winter459316/shenmu/report/support/README.md

# 报告支撑文件

- `migration_evidence_manifest.json`：工程及结果文件索引。
- `evidence_manifest.json`：设计依据文件索引。
- `requirements_host_observed.txt`：依赖信息。

安装依赖以 `board/config/requirements_runtime.txt` 为准。运行文件映射见 `board/config/source_map.json`，包内文件完整性清单见 `data/provenance/manifest.json`。
