winter459316/shenmu/report/architecture.md

# 系统架构与计算分工

```mermaid
flowchart LR
    model[腹腔肿块模型] --> camera[USB 双目摄像头]
    camera --> ps[A53：采集、调度及网络运算]
    ps <--> ddr[AXI 与 DDR 数据交接]
    ddr <--> pl1[PL1：视觉增强、坐标及截面]
    ddr <--> pl2[PL2：双目校正、卷积与反卷积]
    ddr <--> pl3[PL3：FP32 三维卷积]
    ps <--> pc[电脑：网格、纹理及网页交互]
    pc --> display[板端 HDMI 显示]
```

三套完整 PL 配置在同一片 XCZU4EV 上分阶段装载。各套配置的资源占用分别统计。

相机输入为左右拼接的 1280×480 图像。单眼重建输入为 320×360，网络内部高度补齐至 384，执行两次迭代。PL 承担映射到硬件的算子，A53 完成其余网络运算。

PL1 接收 FP32 视差和 FP64 Q 矩阵，使用 FP64 中间运算生成 FP32 毫米坐标。电脑端根据坐标组织网格、附加纹理并提供交互显示。观测坐标与显示补面分别保存。
