winter459316/shenmu/sim/results/project_path_audit.tsv

pl1 | 652 | PASS
pl2 | 557 | PASS
pl3 | 279 | PASS
