winter459316/shenmu/src/ps/display/api_health_fix.py

from pathlib import Path
import hashlib,json,sys
H=Path('/tmp/usb_stereo_probe/pl_pipeline_20261025');R=H.parent/'fast_infer2';S=H.parent/'usb320_hdmifps';sys.path[:0]=[str(H),str(S),str(R)]
from install_hdmi_v4 import process,terminate,launch
from switch_320_board import owners
assert not (R/'pl_test_private_snapshot.json').exists()
for root in (H,R):
 p=root/'hdmi_job_server_v4.py';assert hashlib.sha256(p.read_bytes()).hexdigest()=='a1bfd3c786d58272532138830ca8dd757a2122adfddeb455cc71b33b6ef68cb5';p.write_text('"""Small board job API; only explicit one-shot capture, never automatic looping."""\nfrom pathlib import Path\nfrom http.server import BaseHTTPRequestHandler,ThreadingHTTPServer\nfrom urllib.parse import urlsplit,parse_qs\nimport fcntl,json,re,subprocess,threading,time\nfrom cache_release import acknowledge\nR=Path(__file__).resolve().parent;PORT=8853\nlock=threading.Lock();active=None;latest=None\n\nclass H(BaseHTTPRequestHandler):\n    def allowed(self):\n        return self.client_address[0]==\'192.168.137.1\' and self.headers.get(\'Host\')==\'192.168.137.2:8853\'\n    def data(self,data,code=200,mime=\'application/json\'):\n        if not isinstance(data,bytes):data=json.dumps(dict(data,server_monotonic=time.monotonic())).encode()\n        self.send_response(code);self.send_header(\'Content-Type\',mime);self.send_header(\'Content-Length\',str(len(data)));self.send_header(\'Cache-Control\',\'no-store\');self.end_headers()\n        try:self.wfile.write(data)\n        except (BrokenPipeError,ConnectionResetError):pass\n    def do_GET(self):\n        if not self.allowed():self.send_error(403);return\n        route=urlsplit(self.path);job=parse_qs(route.query).get(\'id\',[latest])[0]\n        if route.path==\'/health\':\n            worker={}\n            try:\n                worker=json.loads((R/\'worker_status.json\').read_text());pid=int(worker[\'pid\'])\n                cmd=[x.decode() for x in (Path(\'/proc\')/str(pid)/\'cmdline\').read_bytes().split(b\'\\0\') if x]\n                valid=any(Path(x).name==\'infer_worker_pl3_v5_quad.py\' and Path(x).resolve()==R/\'infer_worker_pl3_v5_quad.py\' for x in cmd)\n                worker[\'ready\']=bool(worker.get(\'ready\') and valid and (R/\'infer.sock\').exists())\n                worker[\'hdmi_hold_active\']=b\'ZU4EV_HDMI_ADDON=hold_replay_v3\' in (Path(\'/proc\')/str(pid)/\'environ\').read_bytes().split(b\'\\0\')\n            except (OSError,ValueError,KeyError):worker={\'ready\':False,\'state\':\'not_started\'}\n            self.data(dict(ready=worker[\'ready\'],version=\'fast_pl3_usable_v5_quad\',model_worker=worker,video_input_version=\'video_stereo_v5_display\',switch_latency_version=\'overlap_v1\'));return\n        if route.path==\'/processing-preview.jpg\':\n            f=R/\'jobs\'/str(latest)/\'processing_preview.jpg\'\n            if active is not None and active.poll() is None and f.is_file():self.data(f.read_bytes(),mime=\'image/jpeg\')\n            else:self.send_error(404)\n            return\n        if not job:self.data(dict(busy=False,stage=\'idle\'));return\n        if not re.fullmatch(\'[0-9a-f]{32}\',job):self.send_error(400);return\n        folder=R/\'jobs\'/job;p=folder/\'status.json\'\n        if not p.exists():\n            failed=job==latest and active is not None and active.poll() is not None\n            self.data(dict(busy=not failed,stage=\'failed\' if failed else \'starting\',job_id=job,error=\'Worker could not acquire the shared capture lock; wait for the other flow to finish\' if failed else \'\'));return\n        s=json.loads(p.read_text())\n        if route.path==\'/status\':\n            if active and active.poll() is not None and s.get(\'busy\'):s.update(busy=False,stage=\'failed\',error=\'Board worker exited before completing restoration; inspect log\')\n            self.data(s)\n        elif route.path==\'/result\' and s.get(\'stage\')==\'ready\':\n            if s.get(\'cache_released_to_pc\'):self.data(dict(error=\'Result is preserved in the PC capture archive\'),410)\n            else:self.data((folder/\'result.npz\').read_bytes(),mime=\'application/octet-stream\')\n        else:self.send_error(409)\n    def do_POST(self):\n        global active,latest\n        if not self.allowed():self.send_error(403);return\n        try:\n            route=urlsplit(self.path)\n            if route.path==\'/capture-frame\':\n                assert self.headers.get(\'Content-Type\')==\'image/png\'\n                job=parse_qs(route.query)[\'id\'][0];assert re.fullmatch(\'[0-9a-f]{32}\',job)\n                n=int(self.headers.get(\'Content-Length\',\'0\'));assert 24<=n<=4*1024**2\n                raw=self.rfile.read(n);assert len(raw)==n and raw[:8]==b\'\\x89PNG\\r\\n\\x1a\\n\'\n                import struct\n                assert raw[12:16]==b\'IHDR\' and struct.unpack(\'>II\',raw[16:24])==(1280,480)\n                with lock,(R.parent/\'fast_pl/capture.lock\').open(\'a+\') as legacy,(R/\'capture.lock\').open(\'a+\') as capture:\n                    for f in (legacy,capture):fcntl.flock(f,fcntl.LOCK_EX|fcntl.LOCK_NB)\n                    assert active is None or active.poll() is not None,\'Fast is busy\'\n                    assert not (R/\'pl_test_private_snapshot.json\').exists(),\'Recovery snapshot remains\'\n                    assert not list(R.glob(\'*.fault\')),\'DMA fault remains\'\n                    worker=json.loads((R/\'worker_status.json\').read_text());assert worker[\'state\']==\'ready\'\n                    folder=R/\'jobs\'/job;folder.mkdir(parents=True,exist_ok=False)\n                    (folder/\'video_input.png\').write_bytes(raw)\n                    (folder/\'request_timing.json\').write_text(json.dumps({\'api_received\':time.monotonic()}))\n                    with (folder/\'run.log\').open(\'wb\') as log:\n                        active=subprocess.Popen([\'python3\',\'-u\',str(R/\'hdmi_capture_overlap_v1.py\'),job,\'--video-input\'],cwd=str(R),stdin=subprocess.DEVNULL,stdout=log,stderr=log,start_new_session=True)\n                    latest=job\n                self.data(dict(accepted=True,job_id=job),202);return\n            if self.path==\'/capture\':\n                assert self.headers.get(\'Content-Type\')==\'application/json\'\n                n=int(self.headers.get(\'Content-Length\',\'0\'));assert 2<=n<=100\n                args=json.loads(self.rfile.read(n));assert set(args)=={\'job_id\'}\n                job=args[\'job_id\'];assert re.fullmatch(\'[0-9a-f]{32}\',job)\n                with lock,(R.parent/\'fast_pl/capture.lock\').open(\'a+\') as legacy,(R/\'capture.lock\').open(\'a+\') as capture:\n                    for f in (legacy,capture):fcntl.flock(f,fcntl.LOCK_EX|fcntl.LOCK_NB)\n                    assert active is None or active.poll() is not None\n                    worker=json.loads((R/\'worker_status.json\').read_text());assert worker[\'state\']==\'ready\'\n                    folder=R/\'jobs\'/job;folder.mkdir(parents=True,exist_ok=False)\n                    (folder/\'request_timing.json\').write_text(json.dumps({\'api_received\':time.monotonic()}))\n                    with (folder/\'run.log\').open(\'wb\') as log:\n                        active=subprocess.Popen([\'python3\',\'-u\',str(R/\'hdmi_capture_overlap_v1.py\'),job],cwd=str(R),stdin=subprocess.DEVNULL,stdout=log,stderr=log,start_new_session=True)\n                    latest=job\n                self.data(dict(accepted=True,job_id=job),202);return\n            assert self.path==\'/cache-ack\' and self.headers.get(\'Content-Type\')==\'application/json\'\n            n=int(self.headers.get(\'Content-Length\',\'0\'));assert 2<=n<=200\n            args=json.loads(self.rfile.read(n))\n            if self.path==\'/cache-ack\':\n                assert set(args)=={\'job_id\',\'package_sha256\'}\n                with lock,(R/\'capture.lock\').open(\'a+\') as capture:\n                    fcntl.flock(capture,fcntl.LOCK_EX|fcntl.LOCK_NB)\n                    self.data(acknowledge(R/\'jobs\',args[\'job_id\'],args[\'package_sha256\']))\n                return\n        except Exception as exc:self.data(dict(error=str(exc)),409)\n    def log_message(self,*args):pass\n\nif __name__==\'__main__\':ThreadingHTTPServer((\'192.168.137.2\',PORT),H).serve_forever()\n')
m=H/'hdmi_addon_manifest_v4.json';d=json.loads(m.read_text());d['hdmi_job_server_v4.py']=hashlib.sha256('"""Small board job API; only explicit one-shot capture, never automatic looping."""\nfrom pathlib import Path\nfrom http.server import BaseHTTPRequestHandler,ThreadingHTTPServer\nfrom urllib.parse import urlsplit,parse_qs\nimport fcntl,json,re,subprocess,threading,time\nfrom cache_release import acknowledge\nR=Path(__file__).resolve().parent;PORT=8853\nlock=threading.Lock();active=None;latest=None\n\nclass H(BaseHTTPRequestHandler):\n    def allowed(self):\n        return self.client_address[0]==\'192.168.137.1\' and self.headers.get(\'Host\')==\'192.168.137.2:8853\'\n    def data(self,data,code=200,mime=\'application/json\'):\n        if not isinstance(data,bytes):data=json.dumps(dict(data,server_monotonic=time.monotonic())).encode()\n        self.send_response(code);self.send_header(\'Content-Type\',mime);self.send_header(\'Content-Length\',str(len(data)));self.send_header(\'Cache-Control\',\'no-store\');self.end_headers()\n        try:self.wfile.write(data)\n        except (BrokenPipeError,ConnectionResetError):pass\n    def do_GET(self):\n        if not self.allowed():self.send_error(403);return\n        route=urlsplit(self.path);job=parse_qs(route.query).get(\'id\',[latest])[0]\n        if route.path==\'/health\':\n            worker={}\n            try:\n                worker=json.loads((R/\'worker_status.json\').read_text());pid=int(worker[\'pid\'])\n                cmd=[x.decode() for x in (Path(\'/proc\')/str(pid)/\'cmdline\').read_bytes().split(b\'\\0\') if x]\n                valid=any(Path(x).name==\'infer_worker_pl3_v5_quad.py\' and Path(x).resolve()==R/\'infer_worker_pl3_v5_quad.py\' for x in cmd)\n                worker[\'ready\']=bool(worker.get(\'ready\') and valid and (R/\'infer.sock\').exists())\n                worker[\'hdmi_hold_active\']=b\'ZU4EV_HDMI_ADDON=hold_replay_v3\' in (Path(\'/proc\')/str(pid)/\'environ\').read_bytes().split(b\'\\0\')\n            except (OSError,ValueError,KeyError):worker={\'ready\':False,\'state\':\'not_started\'}\n            self.data(dict(ready=worker[\'ready\'],version=\'fast_pl3_usable_v5_quad\',model_worker=worker,video_input_version=\'video_stereo_v5_display\',switch_latency_version=\'overlap_v1\'));return\n        if route.path==\'/processing-preview.jpg\':\n            f=R/\'jobs\'/str(latest)/\'processing_preview.jpg\'\n            if active is not None and active.poll() is None and f.is_file():self.data(f.read_bytes(),mime=\'image/jpeg\')\n            else:self.send_error(404)\n            return\n        if not job:self.data(dict(busy=False,stage=\'idle\'));return\n        if not re.fullmatch(\'[0-9a-f]{32}\',job):self.send_error(400);return\n        folder=R/\'jobs\'/job;p=folder/\'status.json\'\n        if not p.exists():\n            failed=job==latest and active is not None and active.poll() is not None\n            self.data(dict(busy=not failed,stage=\'failed\' if failed else \'starting\',job_id=job,error=\'Worker could not acquire the shared capture lock; wait for the other flow to finish\' if failed else \'\'));return\n        s=json.loads(p.read_text())\n        if route.path==\'/status\':\n            if active and active.poll() is not None and s.get(\'busy\'):s.update(busy=False,stage=\'failed\',error=\'Board worker exited before completing restoration; inspect log\')\n            self.data(s)\n        elif route.path==\'/result\' and s.get(\'stage\')==\'ready\':\n            if s.get(\'cache_released_to_pc\'):self.data(dict(error=\'Result is preserved in the PC capture archive\'),410)\n            else:self.data((folder/\'result.npz\').read_bytes(),mime=\'application/octet-stream\')\n        else:self.send_error(409)\n    def do_POST(self):\n        global active,latest\n        if not self.allowed():self.send_error(403);return\n        try:\n            route=urlsplit(self.path)\n            if route.path==\'/capture-frame\':\n                assert self.headers.get(\'Content-Type\')==\'image/png\'\n                job=parse_qs(route.query)[\'id\'][0];assert re.fullmatch(\'[0-9a-f]{32}\',job)\n                n=int(self.headers.get(\'Content-Length\',\'0\'));assert 24<=n<=4*1024**2\n                raw=self.rfile.read(n);assert len(raw)==n and raw[:8]==b\'\\x89PNG\\r\\n\\x1a\\n\'\n                import struct\n                assert raw[12:16]==b\'IHDR\' and struct.unpack(\'>II\',raw[16:24])==(1280,480)\n                with lock,(R.parent/\'fast_pl/capture.lock\').open(\'a+\') as legacy,(R/\'capture.lock\').open(\'a+\') as capture:\n                    for f in (legacy,capture):fcntl.flock(f,fcntl.LOCK_EX|fcntl.LOCK_NB)\n                    assert active is None or active.poll() is not None,\'Fast is busy\'\n                    assert not (R/\'pl_test_private_snapshot.json\').exists(),\'Recovery snapshot remains\'\n                    assert not list(R.glob(\'*.fault\')),\'DMA fault remains\'\n                    worker=json.loads((R/\'worker_status.json\').read_text());assert worker[\'state\']==\'ready\'\n                    folder=R/\'jobs\'/job;folder.mkdir(parents=True,exist_ok=False)\n                    (folder/\'video_input.png\').write_bytes(raw)\n                    (folder/\'request_timing.json\').write_text(json.dumps({\'api_received\':time.monotonic()}))\n                    with (folder/\'run.log\').open(\'wb\') as log:\n                        active=subprocess.Popen([\'python3\',\'-u\',str(R/\'hdmi_capture_overlap_v1.py\'),job,\'--video-input\'],cwd=str(R),stdin=subprocess.DEVNULL,stdout=log,stderr=log,start_new_session=True)\n                    latest=job\n                self.data(dict(accepted=True,job_id=job),202);return\n            if self.path==\'/capture\':\n                assert self.headers.get(\'Content-Type\')==\'application/json\'\n                n=int(self.headers.get(\'Content-Length\',\'0\'));assert 2<=n<=100\n                args=json.loads(self.rfile.read(n));assert set(args)=={\'job_id\'}\n                job=args[\'job_id\'];assert re.fullmatch(\'[0-9a-f]{32}\',job)\n                with lock,(R.parent/\'fast_pl/capture.lock\').open(\'a+\') as legacy,(R/\'capture.lock\').open(\'a+\') as capture:\n                    for f in (legacy,capture):fcntl.flock(f,fcntl.LOCK_EX|fcntl.LOCK_NB)\n                    assert active is None or active.poll() is not None\n                    worker=json.loads((R/\'worker_status.json\').read_text());assert worker[\'state\']==\'ready\'\n                    folder=R/\'jobs\'/job;folder.mkdir(parents=True,exist_ok=False)\n                    (folder/\'request_timing.json\').write_text(json.dumps({\'api_received\':time.monotonic()}))\n                    with (folder/\'run.log\').open(\'wb\') as log:\n                        active=subprocess.Popen([\'python3\',\'-u\',str(R/\'hdmi_capture_overlap_v1.py\'),job],cwd=str(R),stdin=subprocess.DEVNULL,stdout=log,stderr=log,start_new_session=True)\n                    latest=job\n                self.data(dict(accepted=True,job_id=job),202);return\n            assert self.path==\'/cache-ack\' and self.headers.get(\'Content-Type\')==\'application/json\'\n            n=int(self.headers.get(\'Content-Length\',\'0\'));assert 2<=n<=200\n            args=json.loads(self.rfile.read(n))\n            if self.path==\'/cache-ack\':\n                assert set(args)=={\'job_id\',\'package_sha256\'}\n                with lock,(R/\'capture.lock\').open(\'a+\') as capture:\n                    fcntl.flock(capture,fcntl.LOCK_EX|fcntl.LOCK_NB)\n                    self.data(acknowledge(R/\'jobs\',args[\'job_id\'],args[\'package_sha256\']))\n                return\n        except Exception as exc:self.data(dict(error=str(exc)),409)\n    def log_message(self,*args):pass\n\nif __name__==\'__main__\':ThreadingHTTPServer((\'192.168.137.2\',PORT),H).serve_forever()\n'.encode()).hexdigest();m.write_text(json.dumps(d,indent=2))
for item in process('hdmi_job_server_v4.py'):terminate(item)
env=owners()['full_camera.py']['env'];launch('hdmi_job_server_v4.py',env)
print('HEALTH_VERSION_FIXED')
