winter459316/shenmu/src/pl/pl3/hls_source/system/conv44_bcache_quad_board/fp3_conv48_board.v

`timescale 1ns/1ps
module fp3_conv48_board(
 (* X_INTERFACE_INFO = "xilinx.com:signal:clock:1.0 aclk CLK", X_INTERFACE_PARAMETER = "ASSOCIATED_BUSIF S_AXI:M_AXI, ASSOCIATED_RESET aresetn" *) input wire aclk,
 (* X_INTERFACE_INFO = "xilinx.com:signal:reset:1.0 aresetn RST", X_INTERFACE_PARAMETER = "POLARITY ACTIVE_LOW" *) input wire aresetn,
 (* X_INTERFACE_INFO = "xilinx.com:interface:aximm:1.0 S_AXI AWADDR" *) input wire [11:0] s_axi_awaddr,
 (* X_INTERFACE_INFO = "xilinx.com:interface:aximm:1.0 S_AXI AWVALID" *) input wire s_axi_awvalid,
 (* X_INTERFACE_INFO = "xilinx.com:interface:aximm:1.0 S_AXI AWREADY" *) output wire s_axi_awready,
 (* X_INTERFACE_INFO = "xilinx.com:interface:aximm:1.0 S_AXI WDATA" *) input wire [31:0] s_axi_wdata,
 (* X_INTERFACE_INFO = "xilinx.com:interface:aximm:1.0 S_AXI WSTRB" *) input wire [3:0] s_axi_wstrb,
 (* X_INTERFACE_INFO = "xilinx.com:interface:aximm:1.0 S_AXI WVALID" *) input wire s_axi_wvalid,
 (* X_INTERFACE_INFO = "xilinx.com:interface:aximm:1.0 S_AXI WREADY" *) output wire s_axi_wready,
 (* X_INTERFACE_INFO = "xilinx.com:interface:aximm:1.0 S_AXI BRESP" *) output wire [1:0] s_axi_bresp,
 (* X_INTERFACE_INFO = "xilinx.com:interface:aximm:1.0 S_AXI BVALID" *) output wire s_axi_bvalid,
 (* X_INTERFACE_INFO = "xilinx.com:interface:aximm:1.0 S_AXI BREADY" *) input wire s_axi_bready,
 (* X_INTERFACE_INFO = "xilinx.com:interface:aximm:1.0 S_AXI ARADDR" *) input wire [11:0] s_axi_araddr,
 (* X_INTERFACE_INFO = "xilinx.com:interface:aximm:1.0 S_AXI ARVALID" *) input wire s_axi_arvalid,
 (* X_INTERFACE_INFO = "xilinx.com:interface:aximm:1.0 S_AXI ARREADY" *) output wire s_axi_arready,
 (* X_INTERFACE_INFO = "xilinx.com:interface:aximm:1.0 S_AXI RDATA" *) output wire [31:0] s_axi_rdata,
 (* X_INTERFACE_INFO = "xilinx.com:interface:aximm:1.0 S_AXI RRESP" *) output wire [1:0] s_axi_rresp,
 (* X_INTERFACE_INFO = "xilinx.com:interface:aximm:1.0 S_AXI RVALID" *) output wire s_axi_rvalid,
 (* X_INTERFACE_INFO = "xilinx.com:interface:aximm:1.0 S_AXI RREADY" *) input wire s_axi_rready,
 (* X_INTERFACE_INFO = "xilinx.com:interface:aximm:1.0 M_AXI ARID", X_INTERFACE_PARAMETER = "XIL_INTERFACENAME M_AXI, NUM_READ_OUTSTANDING 16, NUM_WRITE_OUTSTANDING 16, NUM_READ_THREADS 16, NUM_WRITE_THREADS 16" *) output wire [3:0] m_axi_arid,
 (* X_INTERFACE_INFO = "xilinx.com:interface:aximm:1.0 M_AXI ARADDR" *) output wire [63:0] m_axi_araddr,
 (* X_INTERFACE_INFO = "xilinx.com:interface:aximm:1.0 M_AXI ARLEN" *) output wire [7:0] m_axi_arlen,
 (* X_INTERFACE_INFO = "xilinx.com:interface:aximm:1.0 M_AXI ARSIZE" *) output wire [2:0] m_axi_arsize,
 (* X_INTERFACE_INFO = "xilinx.com:interface:aximm:1.0 M_AXI ARBURST" *) output wire [1:0] m_axi_arburst,
 (* X_INTERFACE_INFO = "xilinx.com:interface:aximm:1.0 M_AXI ARLOCK" *) output wire m_axi_arlock,
 (* X_INTERFACE_INFO = "xilinx.com:interface:aximm:1.0 M_AXI ARCACHE" *) output wire [3:0] m_axi_arcache,
 (* X_INTERFACE_INFO = "xilinx.com:interface:aximm:1.0 M_AXI ARPROT" *) output wire [2:0] m_axi_arprot,
 (* X_INTERFACE_INFO = "xilinx.com:interface:aximm:1.0 M_AXI ARVALID" *) output wire m_axi_arvalid,
 (* X_INTERFACE_INFO = "xilinx.com:interface:aximm:1.0 M_AXI ARREADY" *) input wire m_axi_arready,
 (* X_INTERFACE_INFO = "xilinx.com:interface:aximm:1.0 M_AXI AWID" *) output wire [3:0] m_axi_awid,
 (* X_INTERFACE_INFO = "xilinx.com:interface:aximm:1.0 M_AXI AWADDR" *) output wire [63:0] m_axi_awaddr,
 (* X_INTERFACE_INFO = "xilinx.com:interface:aximm:1.0 M_AXI AWLEN" *) output wire [7:0] m_axi_awlen,
 (* X_INTERFACE_INFO = "xilinx.com:interface:aximm:1.0 M_AXI AWSIZE" *) output wire [2:0] m_axi_awsize,
 (* X_INTERFACE_INFO = "xilinx.com:interface:aximm:1.0 M_AXI AWBURST" *) output wire [1:0] m_axi_awburst,
 (* X_INTERFACE_INFO = "xilinx.com:interface:aximm:1.0 M_AXI AWLOCK" *) output wire m_axi_awlock,
 (* X_INTERFACE_INFO = "xilinx.com:interface:aximm:1.0 M_AXI AWCACHE" *) output wire [3:0] m_axi_awcache,
 (* X_INTERFACE_INFO = "xilinx.com:interface:aximm:1.0 M_AXI AWPROT" *) output wire [2:0] m_axi_awprot,
 (* X_INTERFACE_INFO = "xilinx.com:interface:aximm:1.0 M_AXI AWVALID" *) output wire m_axi_awvalid,
 (* X_INTERFACE_INFO = "xilinx.com:interface:aximm:1.0 M_AXI AWREADY" *) input wire m_axi_awready,
 (* X_INTERFACE_INFO = "xilinx.com:interface:aximm:1.0 M_AXI RID" *) input wire [3:0] m_axi_rid,
 (* X_INTERFACE_INFO = "xilinx.com:interface:aximm:1.0 M_AXI RDATA" *) input wire [127:0] m_axi_rdata,
 (* X_INTERFACE_INFO = "xilinx.com:interface:aximm:1.0 M_AXI RRESP" *) input wire [1:0] m_axi_rresp,
 (* X_INTERFACE_INFO = "xilinx.com:interface:aximm:1.0 M_AXI RLAST" *) input wire m_axi_rlast,
 (* X_INTERFACE_INFO = "xilinx.com:interface:aximm:1.0 M_AXI RVALID" *) input wire m_axi_rvalid,
 (* X_INTERFACE_INFO = "xilinx.com:interface:aximm:1.0 M_AXI RREADY" *) output wire m_axi_rready,
 (* X_INTERFACE_INFO = "xilinx.com:interface:aximm:1.0 M_AXI WDATA" *) output wire [127:0] m_axi_wdata,
 (* X_INTERFACE_INFO = "xilinx.com:interface:aximm:1.0 M_AXI WSTRB" *) output wire [15:0] m_axi_wstrb,
 (* X_INTERFACE_INFO = "xilinx.com:interface:aximm:1.0 M_AXI WLAST" *) output wire m_axi_wlast,
 (* X_INTERFACE_INFO = "xilinx.com:interface:aximm:1.0 M_AXI WVALID" *) output wire m_axi_wvalid,
 (* X_INTERFACE_INFO = "xilinx.com:interface:aximm:1.0 M_AXI WREADY" *) input wire m_axi_wready,
 (* X_INTERFACE_INFO = "xilinx.com:interface:aximm:1.0 M_AXI BID" *) input wire [3:0] m_axi_bid,
 (* X_INTERFACE_INFO = "xilinx.com:interface:aximm:1.0 M_AXI BRESP" *) input wire [1:0] m_axi_bresp,
 (* X_INTERFACE_INFO = "xilinx.com:interface:aximm:1.0 M_AXI BVALID" *) input wire m_axi_bvalid,
 (* X_INTERFACE_INFO = "xilinx.com:interface:aximm:1.0 M_AXI BREADY" *) output wire m_axi_bready,
 output wire irq
);
 fp3_conv48_shell #(.LANES(44)) shell(.aclk(aclk),.aresetn(aresetn),.s_axi_awaddr(s_axi_awaddr),.s_axi_awvalid(s_axi_awvalid),.s_axi_awready(s_axi_awready),.s_axi_wdata(s_axi_wdata),.s_axi_wstrb(s_axi_wstrb),.s_axi_wvalid(s_axi_wvalid),.s_axi_wready(s_axi_wready),.s_axi_bresp(s_axi_bresp),.s_axi_bvalid(s_axi_bvalid),.s_axi_bready(s_axi_bready),.s_axi_araddr(s_axi_araddr),.s_axi_arvalid(s_axi_arvalid),.s_axi_arready(s_axi_arready),.s_axi_rdata(s_axi_rdata),.s_axi_rresp(s_axi_rresp),.s_axi_rvalid(s_axi_rvalid),.s_axi_rready(s_axi_rready),.m_axi_arid(m_axi_arid),.m_axi_araddr(m_axi_araddr),.m_axi_arlen(m_axi_arlen),.m_axi_arsize(m_axi_arsize),.m_axi_arburst(m_axi_arburst),.m_axi_arlock(m_axi_arlock),.m_axi_arcache(m_axi_arcache),.m_axi_arprot(m_axi_arprot),.m_axi_arvalid(m_axi_arvalid),.m_axi_arready(m_axi_arready),.m_axi_awid(m_axi_awid),.m_axi_awaddr(m_axi_awaddr),.m_axi_awlen(m_axi_awlen),.m_axi_awsize(m_axi_awsize),.m_axi_awburst(m_axi_awburst),.m_axi_awlock(m_axi_awlock),.m_axi_awcache(m_axi_awcache),.m_axi_awprot(m_axi_awprot),.m_axi_awvalid(m_axi_awvalid),.m_axi_awready(m_axi_awready),.m_axi_rid(m_axi_rid),.m_axi_rdata(m_axi_rdata),.m_axi_rresp(m_axi_rresp),.m_axi_rlast(m_axi_rlast),.m_axi_rvalid(m_axi_rvalid),.m_axi_rready(m_axi_rready),.m_axi_wdata(m_axi_wdata),.m_axi_wstrb(m_axi_wstrb),.m_axi_wlast(m_axi_wlast),.m_axi_wvalid(m_axi_wvalid),.m_axi_wready(m_axi_wready),.m_axi_bid(m_axi_bid),.m_axi_bresp(m_axi_bresp),.m_axi_bvalid(m_axi_bvalid),.m_axi_bready(m_axi_bready),.irq(irq));
endmodule
